NickVanMarkes/Hexapode/docs/index.md

# Poster
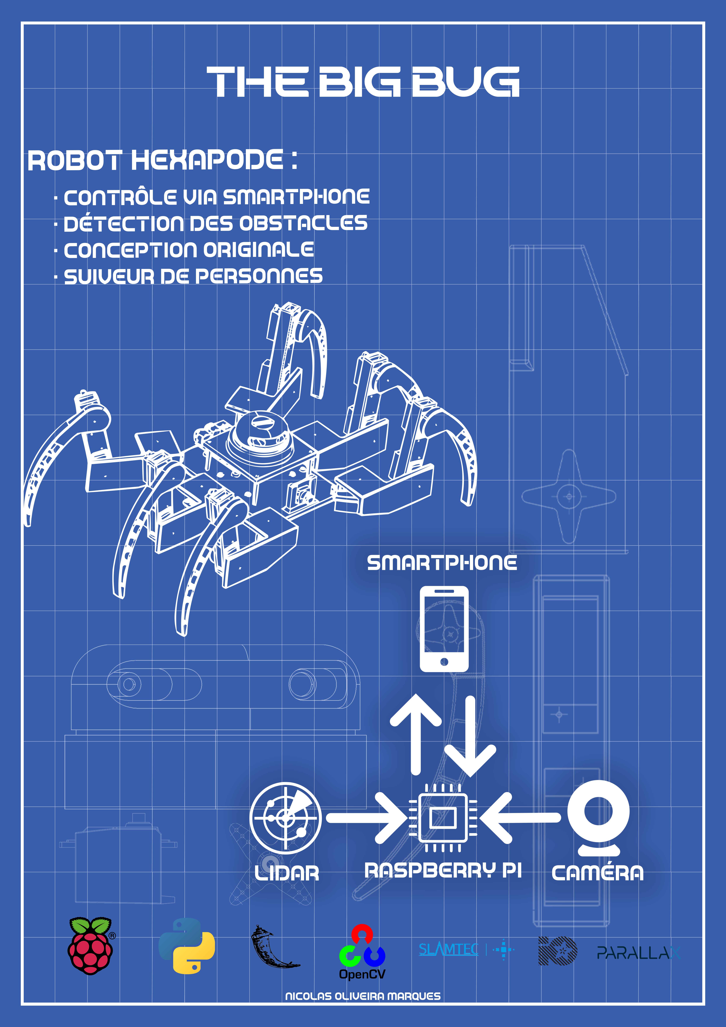
[picture p1: docs/img/JDB/PosterV3_1.png]
POSTER
