NickVanMarkes/Hexapode/docs/Librairies.md

# Librairies et outils externes

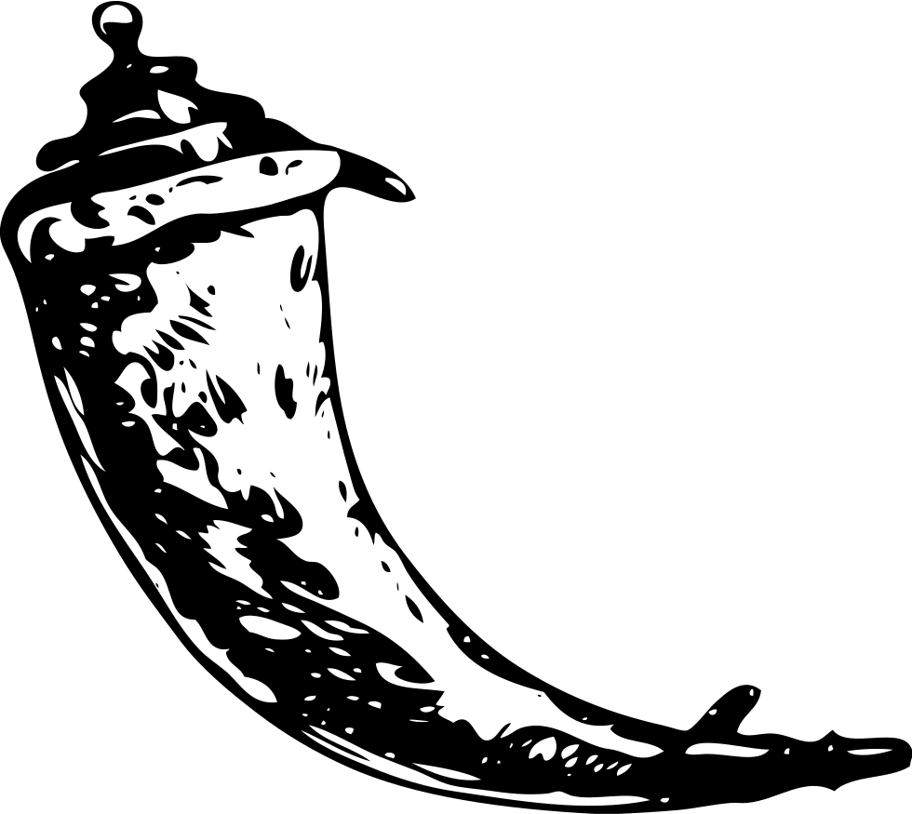
[picture p17: docs/img/FlaskLogo.png]
## Python Flask 

Flask est un framework web, qui permet de rédiger les applications web avec du Python. Flask a été créé par Armin Ronacher, membre de Pocoo, un groupe de développeurs Python formé en 2004 — le 1er avril 2010. Pour cette application j’ai utilisé Python 3.8.10.

### Utilisation

Pour l'utilisation voici un lien vers mon <a href="../Main">code source</a>

## Turbo Flask

Turbo_flask est une extension Flask qui intègre la bibliothèque JavaScript turbo.js à l’application Flask. Le programme utilise majoritairement la fonction push qui actualise juste la partie souhaitée de la page.

### Utilisation

Pour l’utilisation voici un lien vers mon <a href="../Main">code source</a>

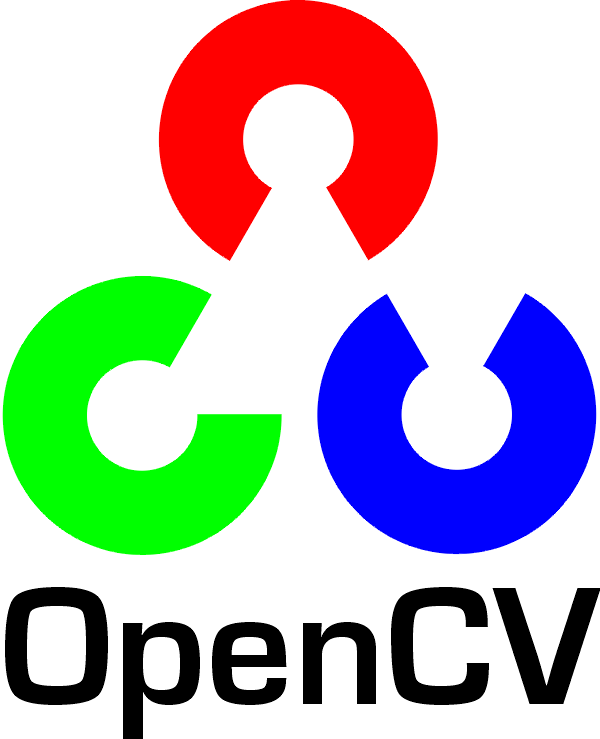
[picture p18: docs/img/OpenCVLogo.png]
## OpenCV 

OpenCV (Open Source Computer Vision Library : http://opencv.org) est une bibliothèque open source qui comprend plusieurs centaines d’algorithmes de vision par ordinateur.

### Utilisation

Pour l’utilisation voici un lien vers deux scripts qui l’utilisent: <a href="../Camera">Camera</a> et <a href="../Plot">Plot</a>

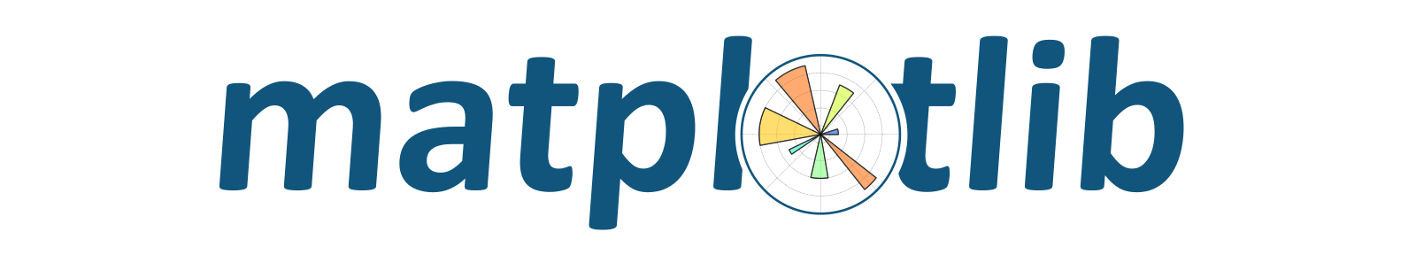
[picture p19: docs/img/MatplotlibLogo.png]
## Matplotlib 
Matplotlib est une bibliothèque Python qui permet de dessiner des diagrammes. Elle est utilisée pour la visualisation de données et le traçage de graphiques.

### Utilisation

Pour l’utilisation voici un lien vers mon <a href="../Plot">code source</a>

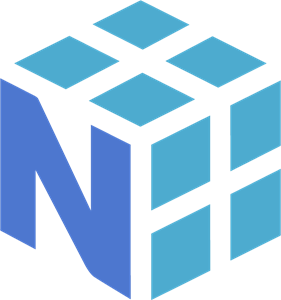
[picture p20: docs/img/NumpyLogo.png]
## NumPy 

NumPy est une bibliothèque pour langage de programmation Python, destinée à manipuler des matrices ou tableaux multidimensionnels ainsi que des fonctions mathématiques opérant sur ces tableaux.

## Simple PID

Simple PID est une librairie destinée à aider afin de faire facilement et rapidement des PID.

### Utilisation

Pour l’utilisation voici un lien vers mon <a href="../Animations_Hexapode">code source</a>

## Servokit adafruit

Servokit d’adafruit est une librairie qui permet de contrôler les servomoteurs du robot grâce au module PCA9685.

### Utilisation

Pour l’utilisation voici un lien vers mon <a href="../Motor">code source</a>

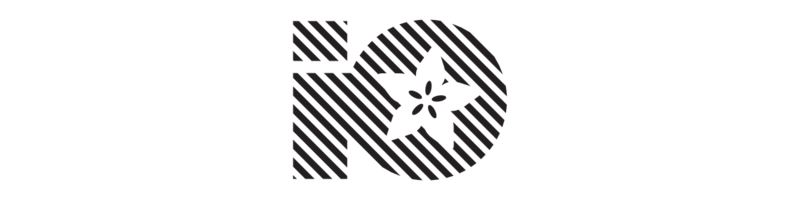
[picture p21: docs/img/AdafruitLogo.png]
## adafruit_rplidar 

Adafruit_rplidar est une librairie faite par adafruit qui permet de communiquer avec le lidar, et est efficace pour l’acquisition des données, puis le contrôle du lidar.

### Utilisation

Pour l’usage voici un lien vers mon <a href="../LidarAsync">code source</a>

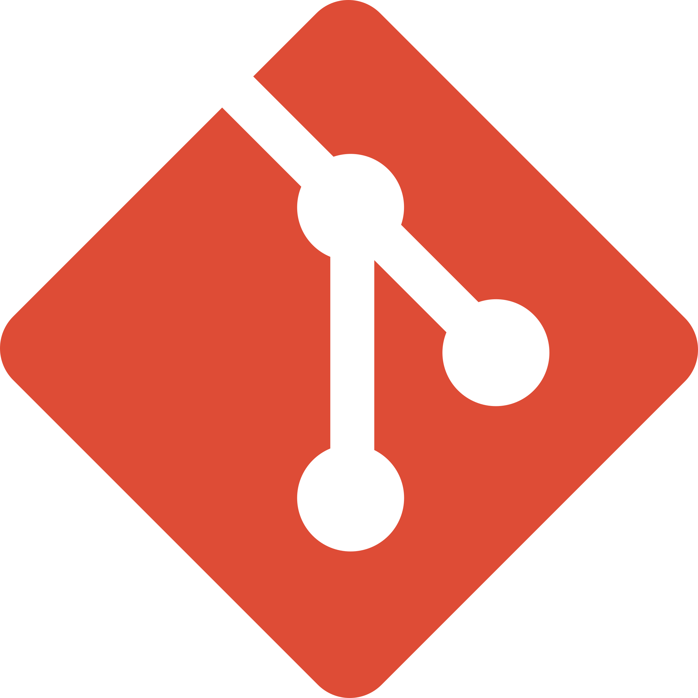
[picture p22: docs/img/GitLogo.png]
## Git 

Git est un logiciel de gestion de version qui a été utilisé durant la réalisation du projet afin d’avoir un historique de celui-ci. Le code source est disponible <a href="https://github.com/NickVanMarkes">ici</a>.

## Trello 
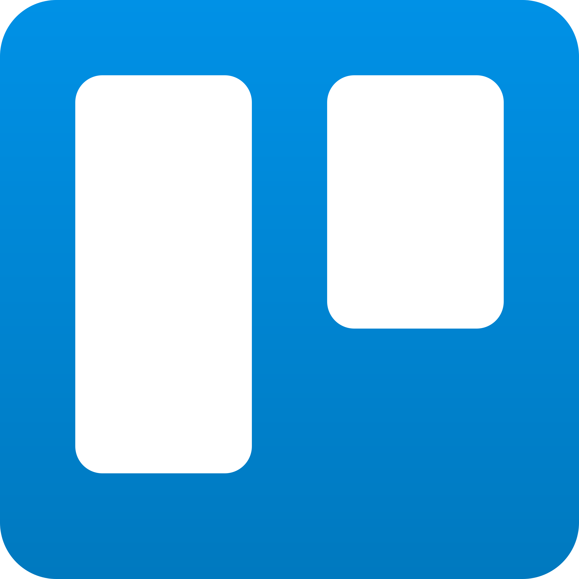
[picture p23: docs/img/TrelloLogo.png]

Trello est un outil de gestion de projet en ligne. Inspiré par la méthode Kanban de Toyota. Il repose sur une organisation des projets en planches, listant des cartes, chacune représentant des tâches.

Vous trouvez <a href="https://trello.com/invite/b/dmw4lQlU/9abc06465e77b2662f28e3f0651a7323/suivis-de-progression-td">ici</a> le trello du projet.

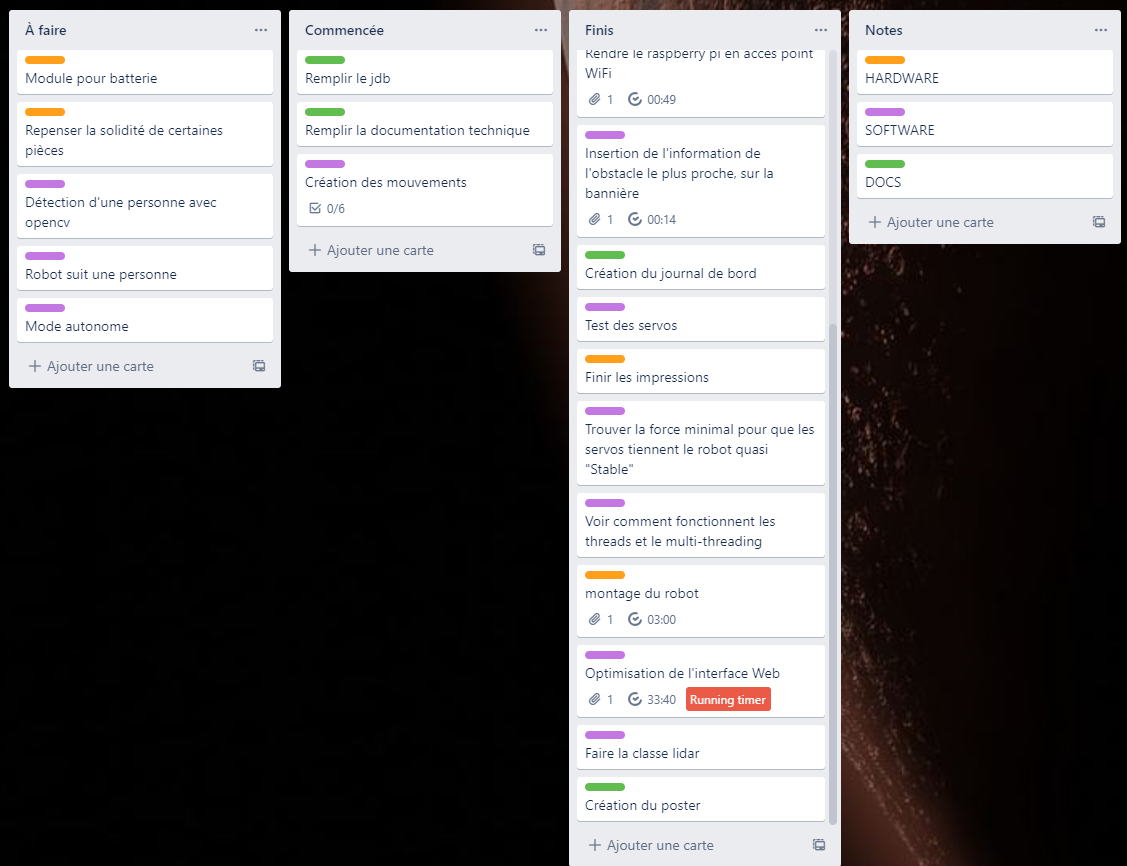
[picture p24: docs/img/Trello.png]
Trello
