NickVanMarkes/Hexapode/docs/Camera.md

# Classe VideoCamera
::: mod_classes.Camera
