NickVanMarkes/Hexapode/docs/Gyroscope.md

# Classe Gyroscope
::: mod_classes.Gyroscope
