NickVanMarkes/Hexapode/docs/LidarAsync.md

# Classe LidarAsync
::: mod_classes.LidarAsync
