NickVanMarkes/Hexapode/mécanique/Main_Board.SLDPRT

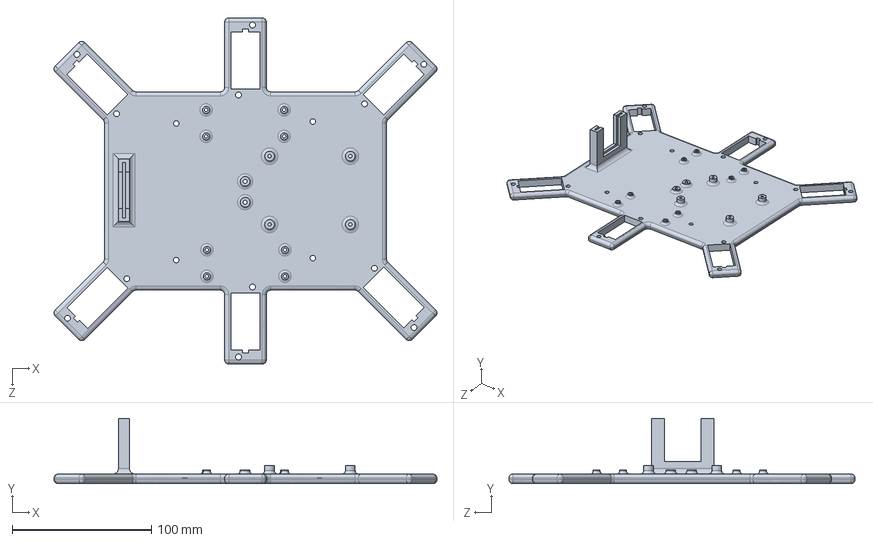
[picture p59: CAD file, 2022-04-11]
mécanique/Main_Board.SLDPRT
274.9 x 47.0 x 248.4 mm
