NickVanMarkes/Hexapode/mécanique/Pointe_patte/pointe_pattev2_plat.SLDPRT

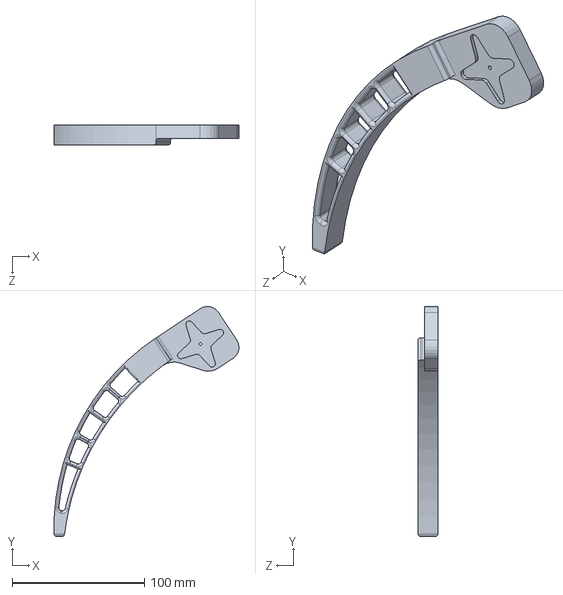
[picture p60: CAD file, 2022-04-11]
mécanique/Pointe_patte/pointe_pattev2_plat.SLDPRT
139.7 x 173.7 x 15.0 mm
