NickVanMarkes/Hexapode/mécanique/Socle_LiDar.SLDPRT

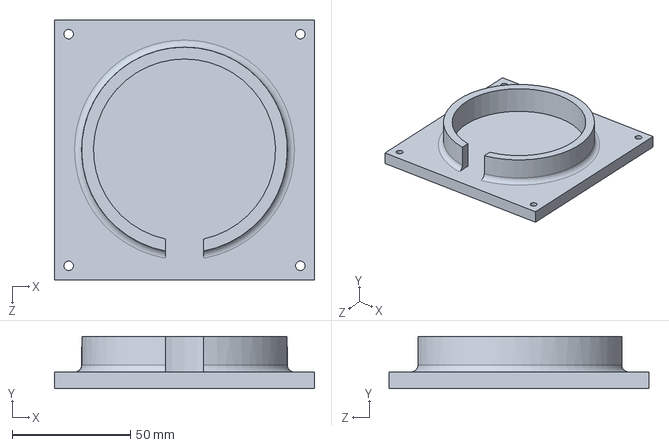
[picture p61: CAD file, 2022-04-11]
mécanique/Socle_LiDar.SLDPRT
110.0 x 22.0 x 110.0 mm
