NickVanMarkes/Hexapode/mécanique/Tibia_patte/tibia_patte_v3_1.SLDPRT

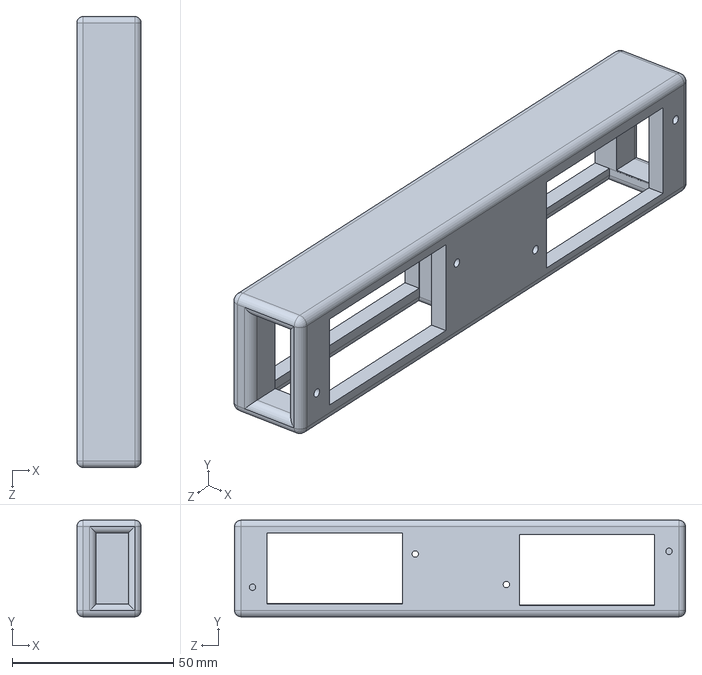
[picture p62: CAD file, 2022-04-11]
mécanique/Tibia_patte/tibia_patte_v3_1.SLDPRT
20.0 x 30.0 x 140.0 mm
