NickVanMarkes/Hexapode/mécanique/Hanche/hancheV2_1.SLDPRT

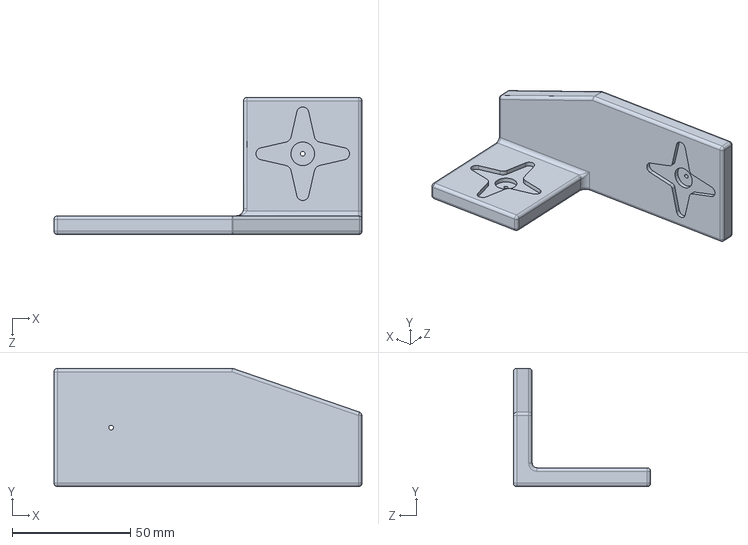
[picture p63: CAD file, 2022-04-11]
mécanique/Hanche/hancheV2_1.SLDPRT
130.0 x 50.0 x 58.0 mm
