NickVanMarkes/Hexapode/mécanique/Pointe_patte/pointe_pattev2.SLDPRT

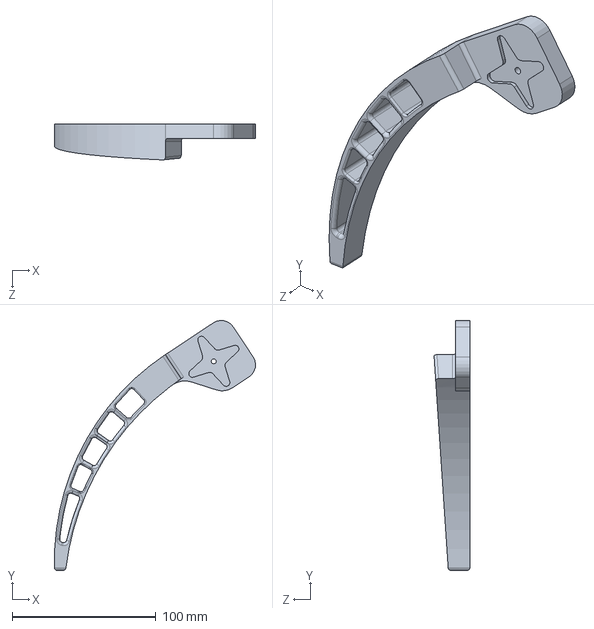
[picture p64: CAD file, 2022-04-11]
mécanique/Pointe_patte/pointe_pattev2.SLDPRT
139.7 x 173.7 x 24.9 mm
