NickVanMarkes/Hexapode/mécanique/Socle_Batterie.SLDPRT

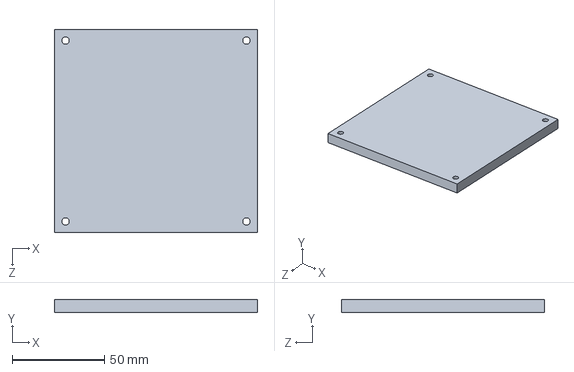
[picture p65: CAD file, 2022-04-11]
mécanique/Socle_Batterie.SLDPRT
110.0 x 7.00 x 110.0 mm
