NickVanMarkes/Hexapode/mécanique/Pointe_patte/pointe_pattev3_plat.SLDPRT

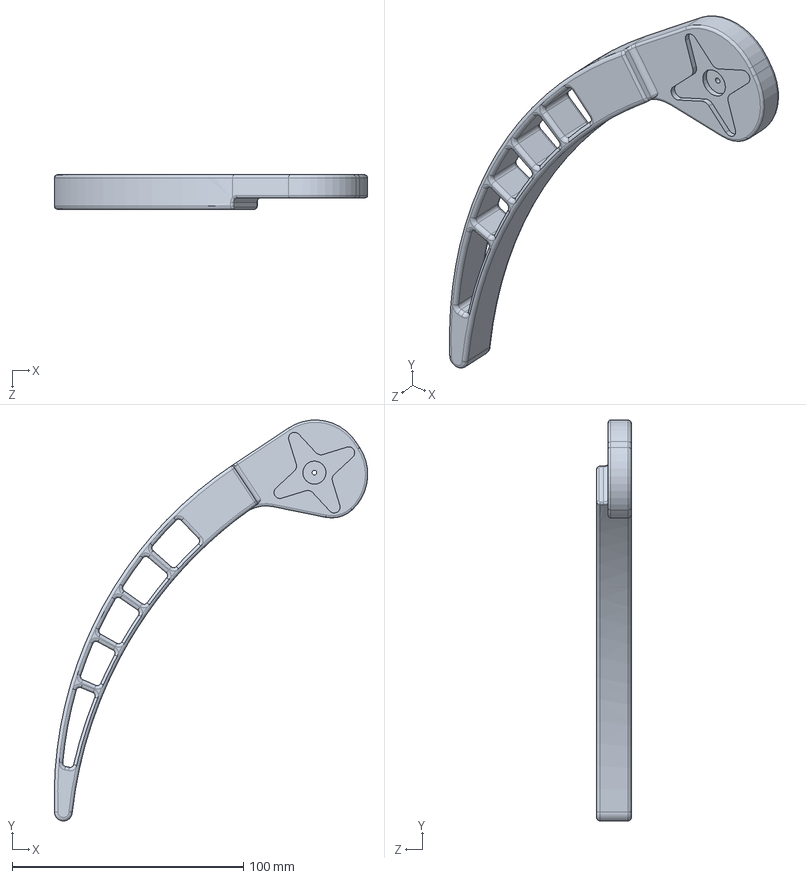
[picture p66: CAD file, 2022-04-11]
mécanique/Pointe_patte/pointe_pattev3_plat.SLDPRT
135.5 x 173.3 x 15.0 mm
