NickVanMarkes/Hexapode/mécanique/Hanche/hancheV2.SLDPRT

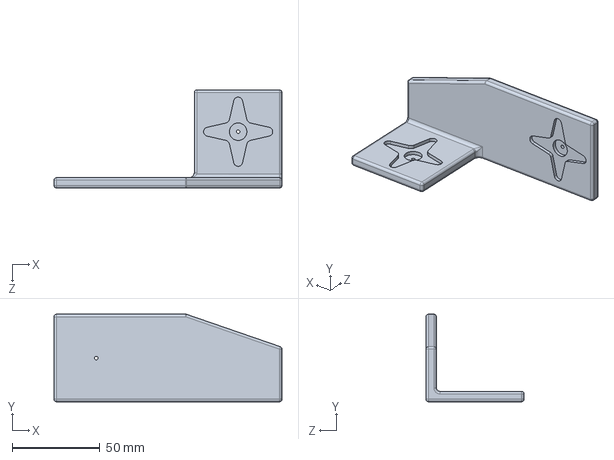
[picture p67: CAD file, 2022-04-11, an earlier design]
mécanique/Hanche/hancheV2.SLDPRT
130.0 x 50.0 x 56.0 mm
