NickVanMarkes/Hexapode/(list of files, cad)

Other CAD files:
mécanique/Hanche/hancheV2_1_mirror.SLDPRT
mécanique/Pointe_patte/pointe_pattev2_1_plat.SLDPRT
