NickVanMarkes/Hexapode/app/mod_classes/Leg.py

### Author      : Nicolas Oliveira
### Project     : The Big Bug
### File        : app/mod_classes/Patte.py
### Date        : 06/05/2022
### Description : Classe qui contrôle les pattes de l'hexapode.

from Motor import ServoMotor

class Leg(object):

    def __init__ (self,Cote,Position) -> None:
        """  brief: Constructeur de la classe Leg, initialise les moteurs par rapport à l'emplacement de la patte.
             
             parameters  :
                 string
                 string
             
             returns :
                None
        """ 
        if Cote=="Gauche":
            if Position=="Avant":
                self.Pointe=ServoMotor(Cote,2)
                self.Tibia=ServoMotor(Cote,1)
                self.Hanche=ServoMotor(Cote,0)
            elif Position=="Milieu":
                self.Pointe=ServoMotor(Cote,4)
                self.Tibia=ServoMotor(Cote,5)
                self.Hanche=ServoMotor(Cote,6)
            elif Position=="Arriere":
                self.Pointe=ServoMotor(Cote,15)
                self.Tibia=ServoMotor(Cote,13)
                self.Hanche=ServoMotor(Cote,12)
        elif Cote=="Droite":
            if Position=="Avant":
                self.Pointe=ServoMotor(Cote,15)
                self.Tibia=ServoMotor(Cote,14)
                self.Hanche=ServoMotor(Cote,13)
            elif Position=="Milieu":
                self.Pointe=ServoMotor(Cote,4)
                self.Tibia=ServoMotor(Cote,5)
                self.Hanche=ServoMotor(Cote,6)
            elif Position=="Arriere":
                self.Pointe=ServoMotor(Cote,0)
                self.Tibia=ServoMotor(Cote,1)
                self.Hanche=ServoMotor(Cote,2)
        self.servos=[self.Pointe,self.Tibia,self.Hanche]

    def Lever_Pointe (self,Angle, Force) -> None:
        """  brief: Lève la pointe de la patte.
             
             parameters  :
                 int
                 int
             
             returns :
                None
        """ 
        self.Pointe.SetAngleRel(Angle,Force)
        if Force<0:
            self.Pointe.StayWithForce("-")
        else:
            self.Pointe.StayWithForce("+")

    def Lever_Tibia (self,Angle, Force) -> None:
        """  brief: Lève le tibia de la patte.
             
             parameters  :
                 int
                 int
             
             returns :
                None
        """
        self.Tibia.SetAngleRel(Angle,Force)
        if Force<0:
            self.Tibia.StayWithForce("-")
        else:
            self.Tibia.StayWithForce("+")

    def Baisser_Pointe (self,Angle,Force) -> None:
        """  brief: Baisse la pointe de la patte.
             
             parameters  :
                 int
                 int
             
             returns :
                None
        """
        self.Pointe.SetAngleRel(Angle,Force)
        if Force<0:
            self.Pointe.StayWithForce("-")
        else:
            self.Pointe.StayWithForce("+")

    def Baisser_Tibia (self,Angle, Force) -> None:
        """  brief: Baisse le tibia de la patte.
             
             parameters  :
                 int
                 int
             
             returns :
                None
        """
        self.Tibia.SetAngleRel(Angle,Force)
        if Force<0:
            self.Tibia.StayWithForce("-")
        else:
            self.Tibia.StayWithForce("+")

    def Tourner (self,Angle, Force) -> None:
        """  brief: Tourne la patte.
             
             parameters  :
                 int
                 int
             
             returns :
                None
        """
        self.Hanche.SetAngleRel(Angle,Force)
        if Force<0:
            self.Hanche.StayWithForce("-")
        else:
            self.Hanche.StayWithForce("+")
    def WithoutForce(self) -> None:
        """  brief: Enlève la force sur les moteurs.
             
             parameters  :
                 None
             
             returns :
                None
        """
        self.Pointe.WithoutForce()
        self.Tibia.WithoutForce()
        self.Hanche.WithoutForce()
