NickVanMarkes/Hexapode/app/mod_classes/Gyroscope.py

### Author      : Nicolas Oliveira
### Project     : The Big Bug
### File        : Hexapode/app/mod_classes/Gyroscope.py
### Date        : 08/04/2022
### Description : Classe qui permet de récupérer les données du gyroscope, et qui les retournes si besoin.

from mpu6050 import mpu6050

class Gyroscope(object):
    def __init__ (self) -> None:
        """  brief: Initialisation du module Gyroscope.
             
             parameters  :
                 None
             
             returns :
                None
        """  
        self.sensor=mpu6050(0x68)
        self.sensor.set_gyro_range(self.sensor.GYRO_RANGE_2000DEG)
        self.sensor.set_filter_range(self.sensor.FILTER_BW_5)

    def get_angle(self) -> dict[str, float]:
        """  brief: Permet de récupérer les angles du robot.
             
             parameters  :
                 None
             
             returns :
                dict[str,float]
        """ 
         
        return self.sensor.get_accel_data()
    
    def get_acceleration (self) -> dict[str, float]:
        """  brief: Permet de récupérer les accélérations du robot.
             
             parameters  :
                 None
             
             returns :
                dict[str,float]
        """
        return self.sensor.get_gyro_data()
