NickVanMarkes/Hexapode/(commit log)

2022-04-06 Mechanic : Add all the mechanicals parts
    [Main_Board.SLDPRT, Socle_Batterie.SLDPRT, Socle_LiDar.SLDPRT, hancheV2.SLDPRT, hancheV2_1.SLDPRT, hancheV2_1_mirror.SLDPRT, pointe_pattev2.SLDPRT, pointe_pattev2_1_plat.SLDPRT]
2022-04-08 Try to fix the problem with the radar view
    [Camera.py, Plot.py, testplot.py]
2022-04-11 Core : Preparation for the other classes, and fix for lidar
    [Gyroscope.py, Lidarv2.py, Lidarv2_1.py, Lidarv2async.py, Motor.py, Plot.py, testplot.py]
2022-04-11 Core: Creation of the second class lidar and try async
2022-04-12 Try to async Lidar, and tests with the servos
2022-04-13 Core: Test Gyroscope, and try the third leg of the hexapod
2022-04-25 Core: Try to make servo stay at an angle
2022-04-27 Core: Clean some code and try to async Lidar class
2022-04-28 Core: Try multi-threading to Lidar class
2022-04-29 Core: Thread class lidar successful, add class RepeatTimer
2022-05-02 Add Animation class, and a Test for it. Add some function to lidar class
2022-05-06 Core: Add Patte class and worked on Motor scipt, advancement on animations
2022-05-10 Core: Fix gyroscope issue
    [Animations_Hexapode2.py, Gyroscope.py, Motor.py, Patte.py, test_Gyro.py]
2022-05-11 Core: add PID to the movements
2022-05-11 Docs: Update logbook and add Simple-PID to the documentation
2022-05-13 Core: advancement PID and Avance movement
2022-05-19 Core: Make responsive site, and grid on the camera feedback
2022-05-20 Core: Fix the square lines
    [Camera.py, Motor.py, Plot.py]
2022-05-23 Git: Fix problem with github desktop
    [Animations_Hexapode.py, Animations_Hexapode2.py, Camera.py, Gyroscope.py, Leg.py, LidarAsync.py, Lidarv1.py, Lidarv2.py]
2022-05-27 Core: Fix javascript to transparent the radar view
    [Camera.py]
2022-05-31 Docs: Fix source code problems
    [Animations_Hexapode.py, Camera.py, Gyroscope.py, Leg.py, LidarAsync.py, Motor.py, Plot.py, RepeatTimer.py]
2022-06-01 Core: Add Init button, and shutdown button
2022-06-02 Core: Add new buttons action's
2022-06-03 Test: Check a test about the lidar thread
2022-06-07 Core: Try to fix QRCode reader
    [Camera.py]
2022-06-07 Core: Fix color changing in th radar view
    [Plot.py]
2022-06-08 Core: Fix Post issue
    [Camera.py]
2022-06-10 Core: Refactor and fix some bugs
    [Animations_Hexapode.py, Camera.py, LidarAsync.py, Plot.py]
2022-06-14 Core: Fix 360° issue
    [Camera.py]
